SeSAC-mobility-embedded-project-Team2/Highway-Drowsiness-Prevention/Firmware/Control/Control_ECU/Core/Src/main.c

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
/* Includes ------------------------------------------------------------------*/
#include "main.h"

/* USER CODE BEGIN Includes */
#include "stm32f1xx_nucleo.h"
#include "ServoMotor.h"
#include "DC_Motor.h"
#include "Max7219.h"
#include "Buzzer.h"
//#include "PC_Comm.h"
#include <stdio.h>
#include <string.h>
/* USER CODE END Includes */

/* USER CODE BEGIN PTD */
#define BUFSIZE 128
/* USER CODE END PTD */

SPI_HandleTypeDef hspi1;

TIM_HandleTypeDef htim2;
TIM_HandleTypeDef htim3;

UART_HandleTypeDef huart2;	// PC 통신용
UART_HandleTypeDef huart3;	// STM 간 통신용
uint8_t uart2_rcvbyte;      // UART2 임시 수신 바이트

/* USER CODE BEGIN PV */

/*------------------------- 전역 변수 및 상태 정의 추가 -----------------------------*/
// 시스템 상태 정의
typedef enum {
	STATUS_NORMAL  = 0,
	STATUS_WARNING = 1,
	STATUS_DANGER  = 2,
	STATUS_FAULT   = 3
} SystemStatus_t;

// UART 패킷 수신용
uint8_t rxPacket[10];				// UART 패킷 수신용 (ID 2바이트 + 데이터 8바이트 = 총 10바이트)
uint8_t rxIndex = 0;				// 수신 바이트 위치 카운트
uint8_t uart_rcvbyte;				// 1바이트 임시 수신용
volatile uint8_t bPacketReady = 0;	// 패킷 완성 플래그
char debugMsg[100];					// UART 송신용 버퍼

/*------------------------- 전역 변수 및 상태 정의 추가 -----------------------------*/

// 현재 시스템 상태 플래그
SystemStatus_t currentSystemStatus = STATUS_NORMAL;
SystemStatus_t lastStatus = STATUS_NORMAL; // 증복 방지용
SystemStatus_t lastStatusForDebug = STATUS_FAULT;

// for Servo Motor
extern TIM_HandleTypeDef htim2; // TIM2 핸들러 사용

// for DC Motor
extern TIM_HandleTypeDef htim3; // DC 모터용 TIM3

//for UART
uint8_t uart_rcvbuf;
volatile uint8_t bUART_RX = 0;


/* USER CODE END PV */

void SystemClock_Config(void);
static void MX_GPIO_Init(void);
static void MX_TIM2_Init(void);
static void MX_SPI1_Init(void);
static void MX_TIM3_Init(void);
static void MX_USART3_UART_Init(void);
static void MX_USART2_UART_Init(void);
/* USER CODE BEGIN 0 */

/*-------------------------- 수신 콜백 함수 수정 (패킷 조립) --------------------------*/

void HAL_UART_RxCpltCallback(UART_HandleTypeDef *huart)
{
	if(huart->Instance == USART3) // USART2에서 USART3로 수정 완료
	{
		// 1. ID 첫 번째 바이트 확인 (0x04)
		if(rxIndex == 0) {
			if(uart_rcvbyte == 0x04) rxPacket[rxIndex++] = uart_rcvbyte;
			else rxIndex = 0; // 일치하지 않으면 초기화
		}

		// 2. ID 두 번째 바이트 확인 (0x01)
		else if(rxIndex == 1) {
			if(uart_rcvbyte == 0x01) rxPacket[rxIndex++] = uart_rcvbyte;
			else rxIndex = 0; // 일치하지 않으면 초기화
		}

		// 3. 나머지 8바이트 데이터 채우기
		else if(rxIndex >= 2) {
			rxPacket[rxIndex++] = uart_rcvbyte;

			// 총 10바이트가 완성되었는가?
			if(rxIndex >= 10) {
				bPacketReady = 1;
				rxIndex = 0;
			}
		}

		// 다시 1바이트 수신 대기
		HAL_UART_Receive_IT(&huart3, &uart_rcvbyte, 1);
	}

	/*
	else if(huart->Instance == USART2)
	{
		// PC_Comm 모듈로 데이터 전달
		PC_Comm_HandleByte(uart2_rcvbyte);
		HAL_UART_Receive_IT(&huart2, &uart2_rcvbyte, 1);
	}
	*/
}

/*----------------------------- 수신 콜백 함수 수정 -------------------------------*/

/* USER CODE END 0 */

/**
  * @brief  The application entry point.
  * @retval int
  */
int main(void)
{

  /* MCU Configuration--------------------------------------------------------*/

  /* Reset of all peripherals, Initializes the Flash interface and the Systick. */
  HAL_Init();

  /* Configure the system clock */
  SystemClock_Config();

  /* Initialize all configured peripherals */
  MX_GPIO_Init();
  MX_TIM2_Init();
  MX_SPI1_Init();
  MX_TIM3_Init();
  MX_USART3_UART_Init();
  MX_USART2_UART_Init();
  /* USER CODE BEGIN 2 */

  Max7219_Init();			// for MAX7219     초기화
  Servo_Init(&htim2); 		// for Servo Motor 초기화
  DC_Motor_Init(&htim3);	// for DC Motor    초기화
  //PC_Comm_Init(&huart2);

  HAL_UART_Receive_IT(&huart3, &uart_rcvbyte, 1);	// 최초 수신 시작
  //HAL_UART_Receive_IT(&huart2, &uart2_rcvbyte, 1); // UART2 수신 시작


  /* USER CODE END 2 */

  /* Infinite loop */
  /* USER CODE BEGIN WHILE */

  while (1)
  {

	  /* [1] PC 통신 처리 (UART2) */
	  // PC에서 보낸 설정값(예: SET_OPEN:1500)이 있는지 확인하고 변수(g_rotation_time_open 등)를 업데이트합니다.
	  //PC_Comm_Process();


	  // [2] 시스템 상태 패킷 해석 (UART3)
	  if(bPacketReady)
	  {
		  bPacketReady = 0;

		  // ID(2바이트) 이후의 데이터 위치에서 값 추출
		  uint8_t alertLevel = rxPacket[2]; // Index 0 -> 2
		  uint8_t mrmTrigger = rxPacket[3];	// Index 1 -> 3

		  // 위험 상태 판단 로직
		  if(alertLevel == 2 || mrmTrigger == 1)
		  {
			  currentSystemStatus = STATUS_DANGER;
		  }
		  else if(alertLevel == 1)
		  {
			  currentSystemStatus = STATUS_WARNING;
		  }
		  else if(alertLevel == 3)
		  {
			  currentSystemStatus = STATUS_FAULT;
		  }
		  else
		  {
			  currentSystemStatus = STATUS_NORMAL;
		  }


	  }


	  // --- 여기서부터 상태 플래그에 따라 모듈 제어 예정 ---


	  /* [3] 상태 변화 시 1회성 트리거 동작 */
	  if (currentSystemStatus != lastStatus)
	  {
		  // 상태가 바뀌는 순간에만 필요한 초기화 작업 수행
		  // 주의: 여기서 긴 HAL_Delay를 사용하면 DC 모터의 감속이 멈춥니다.
		  if (currentSystemStatus == STATUS_NORMAL) {
			  Max7219_All_Off();
		  }
		  lastStatus = currentSystemStatus;
	  }

	  /* [4] 모듈별 실시간 업데이트 (비차단 방식) */
	  // 모든 모듈은 내부적으로 HAL_GetTick()을 사용하여 병렬적으로 동작합니다.
	  Buzzer_Update((uint8_t)currentSystemStatus);

	  // Servo_Update는 내부에서 전역 변수(g_rotation_time_open 등)를 사용하여 동작합니다.
	  Servo_Update((uint8_t)currentSystemStatus);

	  // DC 모터의 3초 선형 감속 로직 실행
	  DC_Motor_Update((uint8_t)currentSystemStatus);

	  // 도트 매트릭스 비차단 스크롤 출력
	  Max7219_Update((uint8_t)currentSystemStatus);

	  /* [5] 시스템 안정성을 위한 미세 딜레이 */
	  HAL_Delay(10);

    /* USER CODE END WHILE */

    /* USER CODE BEGIN 3 */
  }
  /* USER CODE END 3 */
}

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
