SeSAC-mobility-embedded-project-Team2/Highway-Drowsiness-Prevention/Firmware/Body/Body_ECU_f072rb/Body_ECU_f072rb.ioc

Mcu.UserName=STM32F072RBTx
PA0.Signal=ADC_IN0
PA1.GPIO_Label=Touch_I/O_1
PA1.Signal=GPIO_Input
PA13.GPIO_Label=TMS
PA13.Signal=SYS_SWDIO
PA14.GPIO_Label=TCK
PA14.Signal=SYS_SWCLK
PA2.GPIO_Label=USART_TX
PA2.Signal=USART2_TX
PA3.GPIO_Label=USART_RX
PA3.Signal=USART2_RX
PA5.GPIO_Label=LD2 [Green Led]
PA5.Signal=GPIO_Output
PA6.Signal=S_TIM3_CH1
PB6.GPIO_Label=Supersonic_trig
PB6.Signal=GPIO_Output
PB8.Signal=CAN_RX
PB9.Signal=CAN_TX
PC13.GPIO_Label=B1 [Blue PushButton]
PC13.Signal=GPXTI13
PC14-OSC32_IN.Signal=RCC_OSC32_IN
PC15-OSC32_OUT.Signal=RCC_OSC32_OUT
PF0-OSC_IN.Signal=RCC_OSC_IN
PF1-OSC_OUT.Signal=RCC_OSC_OUT
