SeSAC-mobility-embedded-project-Team2/Highway-Drowsiness-Prevention/Firmware/Chassis/446STEARING/Core/Src/main.c

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
/* Includes ------------------------------------------------------------------*/
#include "main.h"

/* USER CODE BEGIN Includes */
#include <stdio.h>
#include <stdlib.h>
#include <math.h>
#include <string.h>
#include <can_message.h>
/* USER CODE END Includes */

CAN_HandleTypeDef hcan1;

TIM_HandleTypeDef htim3;
TIM_HandleTypeDef htim4;

UART_HandleTypeDef huart2;

/* USER CODE BEGIN PV */

#define SAMPLE_SIZE 30
float angle_buffer[SAMPLE_SIZE];
int buffer_index = 0;

float physical_std_dev = 0.0f;
float current_angle = 0.0f;

// CAN 명세 반영 변수
uint16_t can_std_raw = 0;      // Factor 0.01 (StdDev * 100)
int16_t  can_angle_raw = 0;    // Factor 0.1 (Angle * 10)
uint8_t  alive_cnt = 0;        // 0~15 Rolling Counter
uint8_t  err_flag = 0;         // 0:OK, 1:EncoderFail

uint32_t last_cycle_tick = 0;
char uart_buf[120];

CAN_TxHeaderTypeDef txHeader;
Chassis_Data_t sChassis;
uint32_t txMailbox;





/* USER CODE END PV */

void SystemClock_Config(void);
static void MX_GPIO_Init(void);
static void MX_CAN1_Init(void);
static void MX_TIM3_Init(void);
static void MX_TIM4_Init(void);
static void MX_USART2_UART_Init(void);
/* USER CODE BEGIN PFP */

float Calculate_Physical_StdDev(float *data, int size);
void CAN_Send_Chassis_Status(void);

/* USER CODE END PFP */

/**
  * @brief  The application entry point.
  * @retval int
  */
int main(void)
{

  /* MCU Configuration--------------------------------------------------------*/

  /* Reset of all peripherals, Initializes the Flash interface and the Systick. */
  HAL_Init();

  /* Configure the system clock */
  SystemClock_Config();

  /* Initialize all configured peripherals */
  MX_GPIO_Init();
  MX_CAN1_Init();
  MX_TIM3_Init();
  MX_TIM4_Init();
  MX_USART2_UART_Init();
  /* USER CODE BEGIN 2 */

  // 1. CAN 필터 기본 설정 (모든 메시지 수용)
  CAN_FilterTypeDef  sFilterConfig;
  sFilterConfig.FilterBank = 0;
  sFilterConfig.FilterMode = CAN_FILTERMODE_IDMASK;
  sFilterConfig.FilterScale = CAN_FILTERSCALE_32BIT;
  sFilterConfig.FilterIdHigh = 0x0000;
  sFilterConfig.FilterIdLow = 0x0000;
  sFilterConfig.FilterMaskIdHigh = 0x0000;
  sFilterConfig.FilterMaskIdLow = 0x0000;
  sFilterConfig.FilterFIFOAssignment = CAN_RX_FIFO0;
  sFilterConfig.FilterActivation = ENABLE;
  HAL_CAN_ConfigFilter(&hcan1, &sFilterConfig);

  // 2. 주변기기 시작
  HAL_TIM_Encoder_Start(&htim4, TIM_CHANNEL_ALL);
  HAL_CAN_Start(&hcan1);

  // 브레이크 해제
  HAL_GPIO_WritePin(GPIOA, BRAKE_B_Pin, GPIO_PIN_RESET);
  /* USER CODE END 2 */

  /* Infinite loop */
  /* USER CODE BEGIN WHILE */
  while (1)
  {
	  if (HAL_GetTick() - last_cycle_tick >= 100) {
	          last_cycle_tick = HAL_GetTick();

	          // [Step 1] 데이터 읽기 및 변환
	          int16_t raw_cnt = (int16_t)__HAL_TIM_GET_COUNTER(&htim4);
	          current_angle = (float)raw_cnt * (360.0f / 384.0f);

	          angle_buffer[buffer_index] = current_angle;
	          buffer_index = (buffer_index + 1) % SAMPLE_SIZE;

	          physical_std_dev = Calculate_Physical_StdDev(angle_buffer, SAMPLE_SIZE);

	          // [Step 2] 명세서 Factor 적용
	          // StdDev: Factor 0.01 -> 실제값 * 100
	          can_std_raw = (uint16_t)(physical_std_dev * 100.0f);
	          // Angle: Factor 0.1 -> 실제값 * 10
	          can_angle_raw = (int16_t)(current_angle * 10.0f);

	          // [Step 3] CAN 송신
	          CAN_Send_Chassis_Status();

	          // [Step 4] 디버깅 출력 (8바이트 전체 덤프)
	          uint8_t *pDebug = (uint8_t*)&sChassis; // 구조체를 바이트 포인터로 참조

	          int len = sprintf(uart_buf, "Ang:%6.1f|Std:%5.2f|Alive:%2d|Raw:[%02X %02X %02X %02X %02X %02X %02X %02X]\r\n",
	                            current_angle, physical_std_dev, alive_cnt,
	                            pDebug[0], pDebug[1], pDebug[2], pDebug[3],
	                            pDebug[4], pDebug[5], pDebug[6], pDebug[7]); // 7번 인덱스까지 모두 출력

	          HAL_UART_Transmit(&huart2, (uint8_t*)uart_buf, len, 100);
	      }
	      HAL_Delay(1);
    /* USER CODE END WHILE */

    /* USER CODE BEGIN 3 */
  }
  /* USER CODE END 3 */
}

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
/* USER CODE BEGIN 4 */

/**
 * @brief Calculate Standard Deviation and apply CAN factor
 * @param data: pointer to angle buffer
 * @param size: number of samples
 * @return float: Physical standard deviation value
 */
float Calculate_Physical_StdDev(float *data, int size) {
    double sum = 0;
    double mean = 0.0;
    double variance_sum = 0.0;

    for(int i = 0; i < size; i++) sum += data[i];
    mean = sum / size;

    for(int i = 0; i < size; i++) {
        variance_sum += pow(data[i] - mean, 2);
    }

    return (float)sqrt(variance_sum / size);
}

/**
 * @brief Send Chassis_Data (0x201) via CAN
 * @param raw_std: 16-bit value (Physical StdDev * 10)
 */
void CAN_Send_Chassis_Status(void) {
    txHeader.StdId = CAN_ID_CHASSIS; // 0x201
    txHeader.IDE = CAN_ID_STD;
    txHeader.RTR = CAN_RTR_DATA;
    txHeader.DLC = 8;

    // 1. 구조체 초기화 (이전 데이터 잔상 제거)
    memset(&sChassis, 0, sizeof(Chassis_Data_t));

    // 2. 리틀 엔디언 방식으로 데이터 직접 대입
    sChassis.steering_std_dev = (uint16_t)(physical_std_dev * 100.0f);
    sChassis.steering_angle   = (int16_t)(current_angle * 10.0f);
    sChassis.alive_cnt = alive_cnt;
    sChassis.err_flag  = err_flag;

    // 3. 별도의 TxData 배열 없이 구조체 주소를 직접 전달 (캐스팅 활용)
    if (HAL_CAN_GetTxMailboxesFreeLevel(&hcan1) > 0) {
        // (uint8_t*)&sChassis 를 통해 구조체를 8바이트 배열처럼 취급합니다.
        HAL_CAN_AddTxMessage(&hcan1, &txHeader, (uint8_t*)&sChassis, &txMailbox);
    }

    alive_cnt = (alive_cnt + 1) % 16;
}
/* USER CODE END 4 */
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
