SeSAC-mobility-embedded-project-Team2/Highway-Drowsiness-Prevention/Firmware/Body/Body_ECU_f072rb/Core/Inc/main.h

#define B1_Pin GPIO_PIN_13
#define B1_GPIO_Port GPIOC
#define B1_EXTI_IRQn EXTI4_15_IRQn
#define Touch_I_O_1_Pin GPIO_PIN_1
#define Touch_I_O_1_GPIO_Port GPIOA
#define USART_TX_Pin GPIO_PIN_2
#define USART_TX_GPIO_Port GPIOA
#define USART_RX_Pin GPIO_PIN_3
#define USART_RX_GPIO_Port GPIOA
#define LD2_Pin GPIO_PIN_5
#define LD2_GPIO_Port GPIOA
#define TMS_Pin GPIO_PIN_13
#define TMS_GPIO_Port GPIOA
#define TCK_Pin GPIO_PIN_14
#define TCK_GPIO_Port GPIOA
#define Supersonic_trig_Pin GPIO_PIN_6
#define Supersonic_trig_GPIO_Port GPIOB
