SeSAC-mobility-embedded-project-Team2/Highway-Drowsiness-Prevention/Firmware/Body/Body_ECU_f072rb/Core/Src/main.c

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
/* Includes ------------------------------------------------------------------*/
#include "main.h"

/* USER CODE BEGIN Includes */
#include "sensor_ultrasonic.h"
#include "sensor_co2.h"
#include "sensor_touch.h"
#include "can_handler.h"

#include <stdio.h>
/* USER CODE END Includes */

ADC_HandleTypeDef hadc;

CAN_HandleTypeDef hcan;

TIM_HandleTypeDef htim3;
TIM_HandleTypeDef htim6;

UART_HandleTypeDef huart2;

void SystemClock_Config(void);
static void MX_GPIO_Init(void);
static void MX_ADC_Init(void);
static void MX_CAN_Init(void);
static void MX_TIM3_Init(void);
static void MX_TIM6_Init(void);
static void MX_USART2_UART_Init(void);
/* USER CODE BEGIN 0 */

// 인터럽트 콜백 통합 관리
void HAL_TIM_IC_CaptureCallback(TIM_HandleTypeDef *htim){
	Ultrasonic_Capture_Callback(htim);
}

// 마이크로초 지연 함수 (초음파센서 trigger 용)
void delay_us(uint16_t us){
	__HAL_TIM_SET_COUNTER(&htim3, 0);
	while (__HAL_TIM_GET_COUNTER(&htim3) < us);
}

// printf 호출 시 USART2로 데이터를 내보내도록 설정
int __io_putchar(int ch) {
    HAL_UART_Transmit(&huart2, (uint8_t *)&ch, 1, 0xFFFF);
    return ch;
}

uint8_t hands_off_counter = 0; // 0.1초마다 증가할 변수
/* USER CODE END 0 */

/**
  * @brief  The application entry point.
  * @retval int
  */
int main(void)
{

  /* MCU Configuration--------------------------------------------------------*/

  /* Reset of all peripherals, Initializes the Flash interface and the Systick. */
  HAL_Init();

  /* Configure the system clock */
  SystemClock_Config();

  /* Initialize all configured peripherals */
  MX_GPIO_Init();
  MX_ADC_Init();
  MX_CAN_Init();
  MX_TIM3_Init();
  MX_TIM6_Init();
  MX_USART2_UART_Init();
  /* USER CODE BEGIN 2 */
  CAN_Config_Filter();						  // CAN 시작 및 필터 설정
  HAL_TIM_IC_Start_IT(&htim3, TIM_CHANNEL_1); // 초음파 캡처 시작
//  HAL_TIM_Base_Start_IT(&htim6);			  // 0.1초 전송용 TIM6 시작

  // --- 캘리브레이션 단계 추가 ---
  HAL_Delay(3000);
  uint16_t avg_dist = Ultrasonic_Get_Avg_Distance();
  Ultrasonic_Set_Baseline(avg_dist);

  HAL_TIM_Base_Start_IT(&htim6);			  // 0.1초 전송용 TIM6 시작

  // 3초 후의 평균 거리를 기준점으로 설정
  uint16_t final_baseline = Ultrasonic_Get_Avg_Distance();
  Ultrasonic_Set_Baseline(final_baseline);

  printf("\r\nCalibration Done!\r\n");
  printf("Baseline Set to: %u cm\r\n", final_baseline);
  printf("Starting CAN Communication...\r\n");
  /* USER CODE END 2 */

  /* Infinite loop */
  /* USER CODE BEGIN WHILE */
  while (1)
  {
    /* USER CODE END WHILE */

    /* USER CODE BEGIN 3 */
  }
  /* USER CODE END 3 */
}

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
/* USER CODE BEGIN 4 */
void HAL_TIM_PeriodElapsedCallback(TIM_HandleTypeDef *htim) {
    if (htim->Instance == TIM6) {
        // 1. 센서 값 읽기
        int8_t delta = Ultrasonic_Get_Head_Delta();
        uint8_t touch = 1;
        hands_off_counter = 0;
        uint8_t raw_dist = (uint8_t)Ultrasonic_Get_Distance();

        // 2. 변경된 명세로 CAN 전송
        CAN_Tx_SensorData(delta, hands_off_counter, raw_dist, touch);

        // 4. (선택) 트리거 발생 - 초음파 센서 측정 시작
		Ultrasonic_Trigger();
    }
}
/* USER CODE END 4 */
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
