SeSAC-mobility-embedded-project-Team2/Highway-Drowsiness-Prevention/Firmware/Gateway/Gateway_FW/Core/Src/main.c

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
/* Includes ------------------------------------------------------------------*/
#include "main.h"

/* USER CODE BEGIN Includes */
#include "can_message.h" // 공통 헤더
#include <gateway_defines.h>
#include <fuzzy_logic.h>
#include <comm_manager.h>
#include <stdio.h>
#include "unity.h"

// [테스트 스위치] 이 줄이 있으면 테스트 모드, 주석(//) 처리하면 정상 모드
//#define CPU_TEST_MODE
/* USER CODE END Includes */

CAN_HandleTypeDef hcan;

TIM_HandleTypeDef htim3;

UART_HandleTypeDef huart1;
UART_HandleTypeDef huart2;
UART_HandleTypeDef huart3;

/* USER CODE BEGIN PV */

#ifdef CPU_TEST_MODE
  volatile uint32_t idle_counter = 0;
  uint32_t max_idle_count = 0;
  uint8_t  benchmark_done = 0; // 기준점 측정 완료 플래그
  volatile uint32_t rx_debug_cnt = 0; // 수신 인터럽트 횟수 카운터
#endif

volatile uint8_t timer_100ms_flag = 0;

// 전역 변수로 선언
DashboardPacket_t tx_packet;

SystemState_t current_state = STATE_NORMAL;

float prev_steering_angle = 0;

uint32_t no_op_timer = 0;

uint8_t risk_score = 0;

CAN_RxHeaderTypeDef RxHeader;

/* USER CODE END PV */

void SystemClock_Config(void);
static void MX_GPIO_Init(void);
static void MX_CAN_Init(void);
static void MX_USART1_UART_Init(void);
static void MX_USART2_UART_Init(void);
static void MX_TIM3_Init(void);
static void MX_USART3_UART_Init(void);
/* USER CODE BEGIN PFP */
void Update_System_State();
extern void Run_ASPICE_Unit_Tests(void);
/* USER CODE END PFP */

/**
  * @brief  The application entry point.
  * @retval int
  */
int main(void)
{

  /* USER CODE BEGIN 1 */
	printf("system start...\r\n");
  /* USER CODE END 1 */

  /* MCU Configuration--------------------------------------------------------*/

  /* Reset of all peripherals, Initializes the Flash interface and the Systick. */
  HAL_Init();

  /* Configure the system clock */
  SystemClock_Config();

  /* Initialize all configured peripherals */
  MX_GPIO_Init();
  MX_CAN_Init();
  MX_USART1_UART_Init();
  MX_USART2_UART_Init();
  MX_TIM3_Init();
  MX_USART3_UART_Init();
  /* USER CODE BEGIN 2 */
    printf("\r\n=======================================================\r\n");
    printf("   ASPICE SWE.4 Unit Verification Report               \r\n");
    printf("-------------------------------------------------------\r\n");
    printf("   Target Project : Drowsiness Prevention System       \r\n");
    printf("   SW Version     : V0.8                               \r\n");
    printf("   Test Date      : %s             \r\n",__DATE__);
    printf("=======================================================\r\n\r\n");

//    Run_ASPICE_Unit_Tests();
    printf("============================================\r\n");

  // === 1. CAN 필터 및 시작 설정  ===
    CAN_FilterTypeDef sFilterConfig;
    sFilterConfig.FilterBank = 0;
    sFilterConfig.FilterMode = CAN_FILTERMODE_IDMASK;
    sFilterConfig.FilterScale = CAN_FILTERSCALE_32BIT;

    // 1. ID: 0x201 (Chassis) 기준
    sFilterConfig.FilterIdHigh = (0x201 << 5);
    sFilterConfig.FilterIdLow = 0x0000;

    // 2. Mask: 0x6FF (0x201과 0x301만 통과시키도록 설정)
    sFilterConfig.FilterMaskIdHigh = (0x6FF << 5);
    sFilterConfig.FilterMaskIdLow = 0x0000;

    sFilterConfig.FilterFIFOAssignment = CAN_RX_FIFO0;
    sFilterConfig.FilterActivation = ENABLE;
    sFilterConfig.SlaveStartFilterBank = 14;

    HAL_CAN_ConfigFilter(&hcan, &sFilterConfig);
    HAL_CAN_Start(&hcan);
    HAL_CAN_ActivateNotification(&hcan, CAN_IT_RX_FIFO0_MSG_PENDING);

    // === 2. UART(Vision) 수신 인터럽트 시작 ===
    HAL_UART_Receive_IT(&huart1, uart_rx_buffer, 8);

    // === 3. Timer3 인터럽트 시작 ===
    HAL_TIM_Base_Start_IT(&htim3);

	#ifdef CPU_TEST_MODE
	  printf("⚠️ TEST MODE: CPU Load Test Started (Loopback)\r\n");
	#else
	  printf("system start...\r\n");
	#endif


  /* USER CODE END 2 */

  /* Infinite loop */
  /* USER CODE BEGIN WHILE */
  while (1)
  {
#ifdef CPU_TEST_MODE
		  idle_counter++; // 테스트 모드일 때만 카운팅
#endif
    /* USER CODE END WHILE */

    /* USER CODE BEGIN 3 */
	  if (timer_100ms_flag == 1)
	  {
		  timer_100ms_flag = 0;

		  Update_System_State();

		  DMS_Send_Dashboard_Data(&huart1, risk_score);

#ifdef CPU_TEST_MODE
        static int time_100ms = 0;
        time_100ms++;

        // 1. [초반 3초] 아무것도 안 하고 기준점(Max Idle) 잡기
        if (time_100ms <= 30)
        {
            if (time_100ms == 30) // 3초 되는 순간 기준점 확정
            {
                 // 지금까지 3초간 센 것을 100ms 단위 평균으로 환산하거나,
                 // 간단히 지금 순간의 카운터 속도를 기준으로 잡음 (여기선 간단화된 로직 사용)
                 // *정확한 방법*: 1초 단위로 끊어서 측정. 아래 로직으로 변경.
            	benchmark_done = 1; // 기준점 확정 플래그
            	printf("\r\n>>> Calibration Done! Starting Stress Test (500 msg/100ms) <<<\r\n");
            }
        }
        // 2. [3초 이후] CAN 폭격 시작 (부하 유발)
        else
        {
            CAN_TxHeaderTypeDef TxHeader;
            uint8_t TxData[8] = {0,};
            uint32_t TxMailbox;

            TxHeader.StdId = 0x123; // 쓰레기 ID (필터에 걸려야 함)
            TxHeader.RTR = CAN_RTR_DATA;
            TxHeader.IDE = CAN_ID_STD;
            TxHeader.DLC = 8;

            // [수정] 부하를 10배로 늘림 (50 -> 500회)
            // 0.1초 안에 500번 인터럽트면 CPU가 꽤 힘들어할 겁니다.
            for(int i=0; i<5000; i++) {
                HAL_CAN_AddTxMessage(&hcan, &TxHeader, TxData, &TxMailbox);
            }
        }

        // 3. 결과 출력 (1초 마다)
        if (time_100ms % 10 == 0)
        {
            // 아직 기준점 못 잡았으면 현재 값을 최대로 가정
            if (benchmark_done == 0) {
                max_idle_count = idle_counter;
                // 3초 지났으면 이제부터 이 값은 고정 (기준점 확정)
                if (time_100ms >= 30) benchmark_done = 1;
                printf("[CALIB] Measuring Baseline... Cnt: %lu\r\n", idle_counter);
            }
            else {
                // 기준점(max_idle_count) 대비 현재 카운트가 얼마나 줄었는지 계산
                float load = (1.0f - (float)idle_counter / max_idle_count) * 100.0f;
                if(load < 0) load = 0;
                printf("[TEST] Load: %.1f%% | Cnt: %lu | Rx Msg: %lu\r\n", load, idle_counter, rx_debug_cnt);
            }

            idle_counter = 0; // 리셋
        }
#endif
	  }

  }
  /* USER CODE END 3 */
}

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
/* USER CODE BEGIN 4 */

// printf 출력을 위한 리타겟팅 함수
#ifdef __GNUC__
int _write(int file, char *ptr, int len)
{
    // 디버깅용 UART 채널.
    HAL_UART_Transmit(&huart2, (uint8_t *)ptr, len, 30);
    return len;
}
#endif

void HAL_TIM_PeriodElapsedCallback(TIM_HandleTypeDef *htim)
{
    if (htim->Instance == TIM3)
    {
        timer_100ms_flag = 1;
    }
}

// 1. UART 수신 콜백 (Vision)
void HAL_UART_RxCpltCallback(UART_HandleTypeDef *huart)
{
    // 매니저에게 버퍼 넘기기
    DMS_Process_UART_Data(huart, uart_rx_buffer);
}

// 2. CAN 수신 콜백 (Chassis, Body)
void HAL_CAN_RxFifo0MsgPendingCallback(CAN_HandleTypeDef *hcan)
{
    CAN_RxHeaderTypeDef RxHeader;
    uint8_t RxData[8];

    if (HAL_CAN_GetRxMessage(hcan, CAN_RX_FIFO0, &RxHeader, RxData) == HAL_OK)
    {
#ifdef CPU_TEST_MODE
    	rx_debug_cnt++;
#endif
        // 매니저에게 패킷 넘기기
        DMS_Process_CAN_Data(&RxHeader, RxData);
    }
}

void Update_System_State()
{
	// 1. 데이터 스냅샷(Snapshot)을 위한 로컬 변수 선언
	VisionData_t  vision_data_local;
	ChassisData_t chassis_data_local;
	BodyData_t    body_data_local;

	// 2. 크리티컬 섹션 (Critical Section): 인터럽트 잠시 중단
	__disable_irq();

    // 3. 전역 변수 값을 로컬 변수로 안전하게 복사
	vision_data_local  = vision_data;
	chassis_data_local = chassis_data;
	body_data_local = body_data;

    // 4. 인터럽트 다시 허용
    __enable_irq();

    // -----------------------------------------------------------
    // 이제부터는 전역변수 대신 로컬 변수(_local)만 사용합니다.
    // -----------------------------------------------------------


    // 비전, 섀시, 바디에서 에러 플래그가 하나라도 0이 아니면 고장 처리
    if (vision_data_local.err_flag != 0 || chassis_data_local.err_flag != 0 || body_data_local.err_flag != 0)
    {
        printf("body_err_flag : %d vision_err_flag : %d chassis_err_flag : %d"
        		" 🔧 SENSOR ERROR DETECTED! (Fail-Safe Mode)\r\n",
        		body_data_local.err_flag,
				vision_data_local.err_flag,
				chassis_data_local.err_flag);

        current_state = STATE_FAULT;

        DMS_Send_Control_Signal(&huart3, STATE_FAULT, 1, 1);

        return;
    }

    float current_angle = chassis_data_local.steering_angle;
    // 변화량 계산 (ABS 매크로 사용)
    float angle_diff = current_angle - prev_steering_angle;

    if (angle_diff < 0) angle_diff = -angle_diff;

    // 변화량이 2.0도 미만이면 무조작으로 간주
    if (angle_diff < 2.0f)
    {
        no_op_timer += 100; // 100ms 증가 (루프 주기)
    }
    else
    {
        no_op_timer = 0; // 조작 감지 시 리셋
        prev_steering_angle = current_angle; // 기준점 갱신
    }

    // 얼굴 인식 여부에 따른 데이터 필터링
    uint8_t safe_perclos = 0;

    if (vision_data_local.is_face_detected == 1)
    {
        safe_perclos = vision_data_local.perclos; // 얼굴 있으면 측정값 사용
    }
    else
    {
        safe_perclos = 0; // 얼굴 없으면 0점 (위험도 계산에서 제외됨)
    }

    // ms -> sec 변환
    float no_op_sec = no_op_timer / 1000.0f;

    risk_score = Compute_Integrated_Risk(
                            safe_perclos,
                            chassis_data_local.steering_std_dev,
                            body_data_local.hands_off_sec,
                            body_data_local.head_delta_cm,
							no_op_sec
                         );

    if (current_state == STATE_NORMAL)
    {
    	if (risk_score >= 75)
    	{
    		current_state = STATE_WARNING;
    	}
    }
    else if (current_state == STATE_WARNING)
    {
    	if (risk_score >= 95)
    	{
    		current_state = STATE_DANGER;  // 95점 이상 위험
    	}
    	else if (risk_score < 60)
    	{
    		current_state = STATE_NORMAL; // 복귀
    	}
    }
    else if (current_state == STATE_DANGER)
    {
    	if (risk_score < 85)
    	{
    		current_state = STATE_WARNING;
    	}
    }

    // MRM 트리거 조건 판단 (예: Danger 상태이거나, 센서가 다 죽었거나)
    uint8_t mrm_cmd = 0;
    if (current_state == STATE_DANGER || current_state == STATE_FAULT)
    {
        mrm_cmd = 1; // 멈춰!
    }


    // 제어 신호 전송 (ICD V0.1.2 규격)
    DMS_Send_Control_Signal(&huart3, current_state, mrm_cmd, 0);


    printf("%3d Risk: %3d | Eye_safe : %3d%% | detected : %3d | Hands: %3.1fs | Head: %3.1f | Steer: %3.1f | NoOp: %3.1fs\r\n",
                vision_data_local.alive_cnt,
        		risk_score,
				safe_perclos,
				vision_data_local.is_face_detected,
                body_data_local.hands_off_sec,
                body_data_local.head_delta_cm,
                chassis_data_local.steering_std_dev,
                no_op_sec
                );
}

// UART 에러 발생 시(노이즈 등) 호출됨 -> 에러 풀고 수신 다시 켜기
void HAL_UART_ErrorCallback(UART_HandleTypeDef *huart)
{
    if (huart->Instance == USART1)
    {
        // 에러 플래그 클리어 및 재수신 시작
        HAL_UART_Receive_IT(huart, uart_rx_buffer, 8);
    }
}
/* USER CODE END 4 */
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
