SeSAC-mobility-embedded-project-Team2/Highway-Drowsiness-Prevention/Software/Vision/mediapipe/MediaPipe_uart_8byte_final.py

import cv2
import mediapipe as mp
import numpy as np
import subprocess
import time
import serial
import struct
from collections import deque
import socket

sock = socket.socket(socket.AF_INET, socket.SOCK_DGRAM)
UDP_IP = "127.0.0.1"
UDP_PORT = 5005
# ... (프로세스 정리 코드 생략) ...

# ==========================================
# [1] 환경 설정 (Configuration)
# ==========================================
# >> [SYS-REQ-IN-01] 전송 주기 설정
TX_CYCLE = 0.1  # 100ms (0.1초) 마다 데이터 전송

# >> 졸음 판단 임계값
EAR_THRESHOLD = 0.20 

# >> PERCLOS 계산을 위한 히스토리 버퍼 설정
FPS_ESTIMATE = 35             
WINDOW_SECONDS = 3       
MAX_HISTORY = FPS_ESTIMATE * WINDOW_SECONDS 

# >> UART 시리얼 통신 설정
SERIAL_PORT = '/dev/ttyAMA0'  
BAUD_RATE = 115200

# >> MediaPipe 눈 좌표 인덱스
LEFT_EYE = [362, 385, 387, 263, 373, 380]
RIGHT_EYE = [33, 160, 158, 133, 153, 144]

# >> 에러 플래그 정의
ERR_OK = 0          
ERR_CAM_FAIL = 1    
ERR_INIT_FAIL = 2   

# ==========================================
# [2] 헬퍼 함수 (Helpers)
# ==========================================

def calculate_ear(landmarks, indices, w, h):
    """ [기능] 눈의 종횡비(EAR) 계산 """
    coords = []
    for idx in indices:
        lm = landmarks[idx]
        coords.append(np.array([lm.x * w, lm.y * h]))
    
    v1 = np.linalg.norm(coords[1] - coords[5])
    v2 = np.linalg.norm(coords[2] - coords[4])
    h_dist = np.linalg.norm(coords[0] - coords[3])
    
    if h_dist == 0: return 0.0
    return (v1 + v2) / (2.0 * h_dist)

def create_dbc_payload(perclos, eye_state_raw, face_detect_flag, alive_cnt, err_flag):
    """ [기능] CAN 인터페이스 사양(DBC)에 맞춰 8바이트 배열 생성 """
    # Byte 0: PERCLOS (0~100)
    byte0 = int(max(0, min(100, perclos)))

    # Byte 1: Eye_State_Raw(Bit 0) | Face_Detect_Flag(Bit 1)
    byte1 = (eye_state_raw & 0x01) | ((face_detect_flag & 0x01) << 1)

    # Byte 2 ~ 6: Reserved (0)
    byte2 = 0; byte3 = 0; byte4 = 0; byte5 = 0; byte6 = 0

    # Byte 7: Alive_Cnt(Bit 0~3) | Err_Flag(Bit 4~7)
    byte7 = (alive_cnt & 0x0F) | ((err_flag & 0x0F) << 4)

    # 8바이트 패킹
    return struct.pack('8B', byte0, byte1, byte2, byte3, byte4, byte5, byte6, byte7)

# [삭제됨] wrap_packet_uart 함수는 더 이상 사용하지 않습니다. (8바이트만 보내기 위해)
# def wrap_packet_uart(payload): ... 

# ==========================================
# [3] 메인 루프 (Main Loop)
# ==========================================
def main():
    # 상태 변수 초기화
    vision_err_flag = ERR_OK
    alive_cnt = 0  # 0~15 롤링 카운터
    
    # UART 시리얼 연결
    ser = None
    try:
        ser = serial.Serial(SERIAL_PORT, BAUD_RATE, timeout=0.1)
        print(f"✅ Serial connected to {SERIAL_PORT}")
    except Exception as e:
        vision_err_flag = ERR_INIT_FAIL
        print(f"⚠️ Serial connection failed: {e}")

    # 카메라 프로세스 실행
    cmd = ['rpicam-vid', '-t', '0', '--width', '640', '--height', '480', 
           '--inline', '--nopreview', '--codec', 'mjpeg', '-o', '-']
    process = subprocess.Popen(cmd, stdout=subprocess.PIPE, stderr=subprocess.DEVNULL)

    # MediaPipe 초기화
    mp_face_mesh = mp.solutions.face_mesh
    face_mesh = mp_face_mesh.FaceMesh(max_num_faces=1, 
                                      refine_landmarks=True,
                                      min_detection_confidence=0.7,
                                      min_tracking_confidence=0.7)

    eye_history = deque(maxlen=MAX_HISTORY)
    bytes_data = b''
    prev_time = 0
    
    # [중요] 전송 주기 타이머 초기화
    last_tx_time = time.time()

    while True:
        # 카메라 영상 데이터 읽기
        bytes_data += process.stdout.read(2048)
        a = bytes_data.find(b'\xff\xd8')
        b = bytes_data.find(b'\xff\xd9')

        if a != -1 and b != -1:
            jpg = bytes_data[a:b+2]
            bytes_data = bytes_data[b+2:]
            
            try:
                image = cv2.imdecode(np.frombuffer(jpg, dtype=np.uint8), cv2.IMREAD_COLOR)
            except: 
                continue 

            if image is None: continue

            h, w, _ = image.shape
            results = face_mesh.process(cv2.cvtColor(image, cv2.COLOR_BGR2RGB))

            # --- [데이터 처리 시작] ---
            face_detect_flag = 0  # 0: None
            eye_state_raw = 0     # 0: Open
            avg_ear = 0.0

            # 1. 얼굴 감지 여부 확인
            if results.multi_face_landmarks:
                face_detect_flag = 1 
                vision_err_flag = ERR_OK 

                for face_landmarks in results.multi_face_landmarks:
                    l_ear = calculate_ear(face_landmarks.landmark, LEFT_EYE, w, h)
                    r_ear = calculate_ear(face_landmarks.landmark, RIGHT_EYE, w, h)
                    avg_ear = (l_ear + r_ear) / 2.0

                    # 시각화 (눈 윤곽선)
                    for eye_indices in [LEFT_EYE, RIGHT_EYE]:
                        pts = np.array([[int(face_landmarks.landmark[i].x * w), 
                                         int(face_landmarks.landmark[i].y * h)] for i in eye_indices])
                        cv2.polylines(image, [pts], True, (0, 255, 255), 1)

                    if avg_ear < EAR_THRESHOLD:
                        eye_state_raw = 1 
                    else:
                        eye_state_raw = 0
                    
                    eye_history.append(eye_state_raw)
            else:
                # 얼굴 미검출
                face_detect_flag = 0
                eye_state_raw = 0   
                # 미검출 시 히스토리 업데이트 안 함

            # 2. PERCLOS 계산 (0~100)
            perclos = 0.0
            if len(eye_history) > 0:
                perclos = (sum(eye_history) / len(eye_history)) * 100

            # --- [데이터 송신: 100ms 주기 체크] ---
            curr_time = time.time()
            
            # [핵심] 0.1초가 지났는지 확인하고 보냄
            if (curr_time - last_tx_time) >= TX_CYCLE:
                
                # 3. Alive Count 증가 (0 ~ 15 반복)
                alive_cnt = (alive_cnt + 1) % 16

                # 패킷 생성 (8바이트)
                payload_8byte = create_dbc_payload(perclos, eye_state_raw, face_detect_flag, alive_cnt, vision_err_flag)
                
                # <<<< [수정됨] wrap_packet_uart 호출 삭제 (11바이트 포장 안 함)
                # final_packet = wrap_packet_uart(payload_8byte) 

                if ser is not None:
                    try:
                        # <<<< [수정됨] payload_8byte를 직접 전송 (Raw 8 Bytes)
                        ser.write(payload_8byte) 
                    except: pass 

                # <<<< [수정됨] 터미널 로그 변경 (UART 8B)
                payload_hex = ' '.join(f'{b:02X}' for b in payload_8byte)
                print(f"[UART 8B] {payload_hex} | Alive:{alive_cnt} Detect:{face_detect_flag} PERCLOS:{perclos:.1f}%")
                
                # 타이머 갱신
                last_tx_time = curr_time

            #  =========================================================
            # [추가 3] UART 수신 및 UDP 중계 (여기에 붙여넣으세요!)
            # =========================================================
            try:
                # 버퍼에 32바이트(헤더포함) 이상 쌓였는지 확인
                if ser.in_waiting >= 32:
                    # 1. 헤더(0xFCFD) 찾기 (Little Endian: FD, FC 순서)
                    # read(1)로 한 바이트씩 읽어서 위치를 맞춥니다.
                    
                    # 첫 바이트가 0xFD인지 확인
                    if ser.read(1) == b'\xfd':
                        # 맞다면, 두 번째 바이트가 0xFC인지 확인
                        if ser.read(1) == b'\xfc':
                            # 헤더를 찾았음! 나머지 30바이트(Payload) 읽기
                            payload = ser.read(30)
                            
                            if len(payload) == 30:
                                # 헤더(FD FC)를 다시 붙여서 완성된 32바이트를 만듦
                                full_packet = b'\xfd\xfc' + payload
                                
                                # 로컬호스트(대시보드 프로그램)로 던짐
                                sock.sendto(full_packet, (UDP_IP, UDP_PORT))
            except Exception as e:
                pass # 통신 에러가 나도 카메라는 멈추면 안 됨!
            # =========================================================

            # --- [화면 시각화] ---
            # 화면은 통신과 무관하게 카메라 속도(30FPS)대로 계속 갱신
            fps = 1 / (curr_time - prev_time) if (curr_time - prev_time) > 0 else 0
            prev_time = curr_time

            cv2.putText(image, f"FPS: {int(fps)}", (30, 460), cv2.FONT_HERSHEY_SIMPLEX, 0.6, (150, 150, 150), 2)
            
            p_color = (0, 255, 0)
            if perclos > 30: p_color = (0, 0, 255)
            elif perclos > 10: p_color = (0, 255, 255)

            cv2.putText(image, f"PERCLOS: {perclos:.1f}%", (30, 60), cv2.FONT_HERSHEY_SIMPLEX, 0.7, p_color, 2)
            
            status_str = "DETECTED" if face_detect_flag else "NONE"
            eye_str = "CLOSED" if eye_state_raw else "OPEN"
            
            color_face = (255, 255, 0) if face_detect_flag else (0, 0, 255)
            cv2.putText(image, f"Face: {status_str}", (30, 90), cv2.FONT_HERSHEY_SIMPLEX, 0.7, color_face, 2)
            cv2.putText(image, f"Eye: {eye_str}", (30, 120), cv2.FONT_HERSHEY_SIMPLEX, 0.7, (0, 255, 255), 2)

            cv2.imshow('Vision Status', image)
            if cv2.waitKey(1) & 0xFF == ord('q'): break

    process.terminate()
    cv2.destroyAllWindows()
    if ser is not None: ser.close()

if __name__ == "__main__":
    main()
