SeSAC-mobility-embedded-project-Team2/Highway-Drowsiness-Prevention/Firmware/Control/Control_ECU/Core/Src/PC_Comm.c

/* PC_Comm.c */
#include "PC_Comm.h"

void PC_Comm_Init(UART_HandleTypeDef *huart) {
    // 내용 비움
}

void PC_Comm_HandleByte(uint8_t byte) {
    // 내용 비움
}

void PC_Comm_Process(void) {
    // 현재 에러가 발생하는 모든 내부 코드를 주석 처리하거나 삭제하세요.
}
