SeSAC-mobility-embedded-project-Team2/Highway-Drowsiness-Prevention/(commit log)

2026-01-13 upload ICD url
    [최종 시나리오 케이스 분류.csv, 최종부품목록.csv]
2026-01-13 init file upload chassis
2026-01-14 CABIN-6 check complete receiving data and printing
2026-01-14 CABIN-6 check complete receiving data from raspberry pi5 vision unit
2026-01-14 feat: Add ServoMotor window control logic and tune rotation time
2026-01-14 CABIN-6 check uart interrupt
2026-01-15 CABIN-6 feature fix function parameter
    [main.c]
2026-01-15 feat: Control ECU 도트 제어 VER.1
2026-01-15 feat: Control ECU 도트 VER.2
2026-01-15 refactoring uart code
2026-01-15 feat: Body_ECU_f072rb setting with supersonic & CO2 sensor
2026-01-15 fix: can_handler.c for Byte matching
    [can_handler.c]
2026-01-15 feat: Control ECU DC모터 제어 함수 추가
2026-01-15 feat: Control ECU UART 통신 ID 업데이트
2026-01-15 feature uart transmit
2026-01-15 CABIN-39 fix delay func
    [main.c]
2026-01-15 CABIN-39 add HW timer
2026-01-15 CABIN-39 100ms HW timer setting
2026-01-15 CABIN-39 fix variable name
    [main.c]
2026-01-16 feat: Control ECU 패킷 분석 함수 변경
2026-01-16 CABIN-39 fix nvic settings
    [Gateway_FW.ioc, main.c]
2026-01-16 CABIN-39 fix uart3 settings
    [Gateway_FW.ioc, comm_manager.c, main.c]
2026-01-16 fix: ultrasonic logic
2026-01-16 CABIN-39 feature fail-safe code addded for body node
    [comm_manager.c, gateway_defines.h, main.c, test_suite.c]
2026-01-16 CABIN-39 fix steering wheel angle data overflow prevention code added
    [main.c]
2026-01-16 CABIN-39 fix steering wheel angle data type int to float. and fix no operation max risk 0.6 to 0.8
    [comm_manager.c, fuzzy_logic.c, gateway_defines.h, main.c]
2026-01-16 CABIN-39 feature race condition prevention code through irq enable/disable
    [main.c]
2026-01-16 feature CAN filter add for only 0x201 0x301 and refactoring unused variables
2026-01-17 fix: delete test code
    [main.c]
2026-01-17 feat: Control ECU 출력 제거 및 패킷 업데이트
2026-01-17 feat: Control ECU 서보 모터 값 수정 및 로직 추가
    [Control_ECU.ioc, PC_Comm.c, PC_Comm.h, ServoMotor.c, ServoMotor.h, main.c]
2026-01-17 fix: white box test(branch coverage)
    [can_handler.c, main.c, sensor_ultrasonic.c]
