SeSAC-mobility-embedded-project-Team2/Highway-Drowsiness-Prevention/(notices)

Notices in the files:
Firmware/Body/Body_ECU_f072rb/Core/Src/main.c:
Copyright (c) 2026 STMicroelectronics.
All rights reserved.
This software is licensed under terms that can be found in the LICENSE file
